onatsimsek/EE464-Hardware-Project-The-Isolated-Ones/README.md

# EE464-Hardware-Project-The-Isolated-Ones
