onatsimsek/EE464-Hardware-Project-The-Isolated-Ones/EE 464 Term Project (1).pptx

## EE 464 Term Project

The Isolated Ones

Selen Özge Özgür 2375566
Onat Şimşek 2375772
Onur Emirhan Con 2304384

## Outline

Topology Selection
Magnetic Design
Simulation Results
Component Selection

## Topology Selection

| Efficiency | Output Ripple | Power Range | Complexity | Cost
Flyback Converter | Moderate efficiency | Higher output ripple | Low to medium power | Least Complex | Cheapest
Forward Converter | Better efficiency | Lowest output ripple | Medium to high power | Medium Complexity | Medium
Push-Pull Converter | Can also have good efficiency | Moderate output ripple | Medium power | Most Complex | Most Expensive

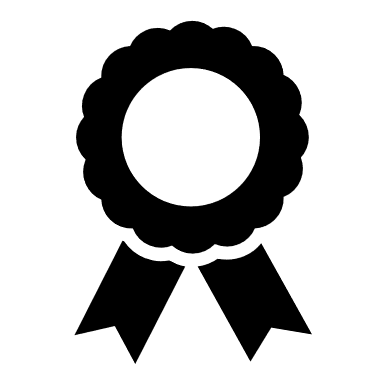
[picture p15: figure]
Ribbon with solid fill

## Topology Selection

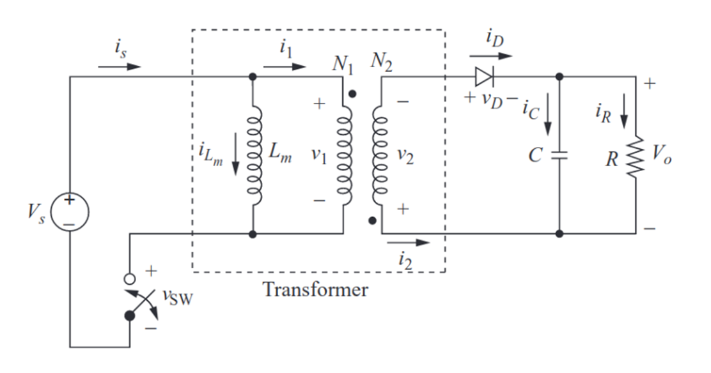
[picture p16: figure]

Flyback Converter

## Magnetic Design

- Duty cycle range is determined
- Turns ratio is determined to be 1:1, according to duty cycle
- Lm is calculated according to specifications (Vin, Dmax, Bmax, etc.)
- Core is determined after some research (ETD 39/20/13)
  - B66363G1000X187 with a gap of 1 mm
  - N87 type SIFERRIT material
- Minimum number of turns required for the primary winding is determined
- Exact number of turns is determined as 11
- Lm is calculated again
- B is calculated again to double check the design

## Magnetic Design

Duty Cycle Range | Turns Ratio | Bmax | Calculated Lm | AL of the Core
0.24-0.39 | 1:1 | 0.2 T | 23.18 μH | 196 nH/T^2

## Magnetic Design

Min # of Turns | # of Turns | Final Lm | Final Bmax | Switching Freq.
≈ 8 | ≈ 11 | 23.72 μH | 0.215 T | 80kHz

## Magnetic Design

Skin Depth | Cable Type | # of Parallel Cables | Window Area of the Core | Fill Factor
0.265 mm | AWG 26 | 27 | 178 mm^2 | 0.46

## Magnetic Design

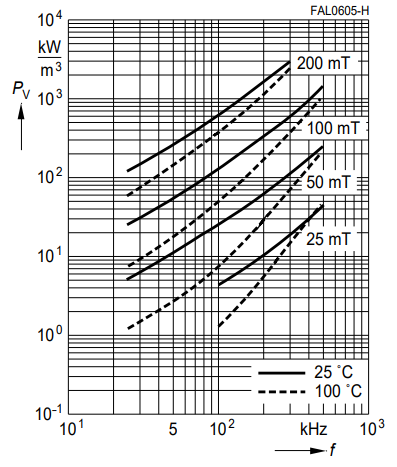
[picture p17: figure]

Copper Losses | Core Losses
0.67 W | 3.45 W

## Magnetic Design Results

Primary Winding Inductance

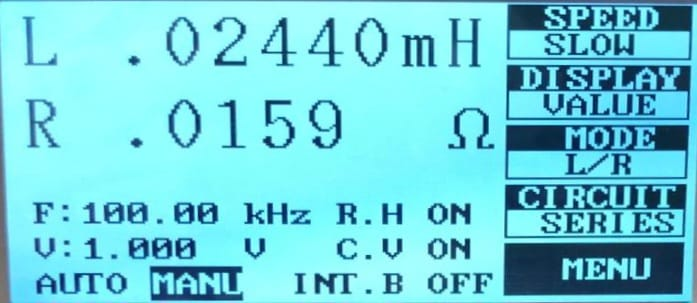
[picture p18: figure]

Leakage Inductance

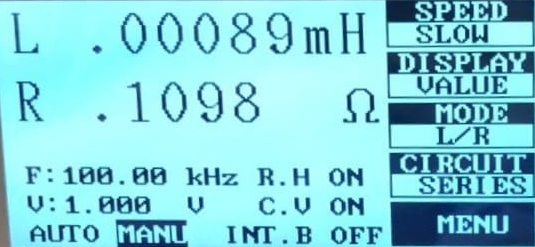
[picture p19: figure]

## Simulation Results

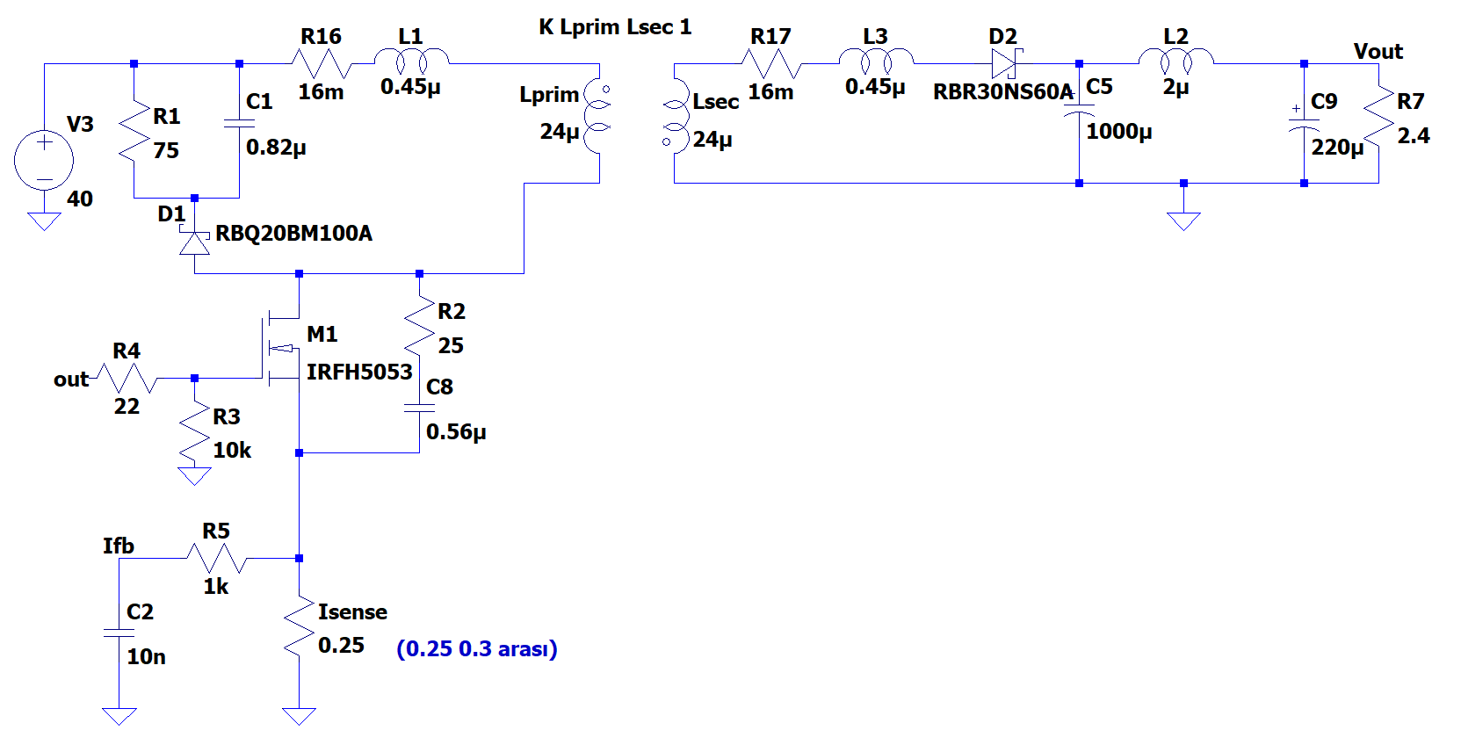
[picture p20: figure]

Flyback Converter Design

## Simulation Results

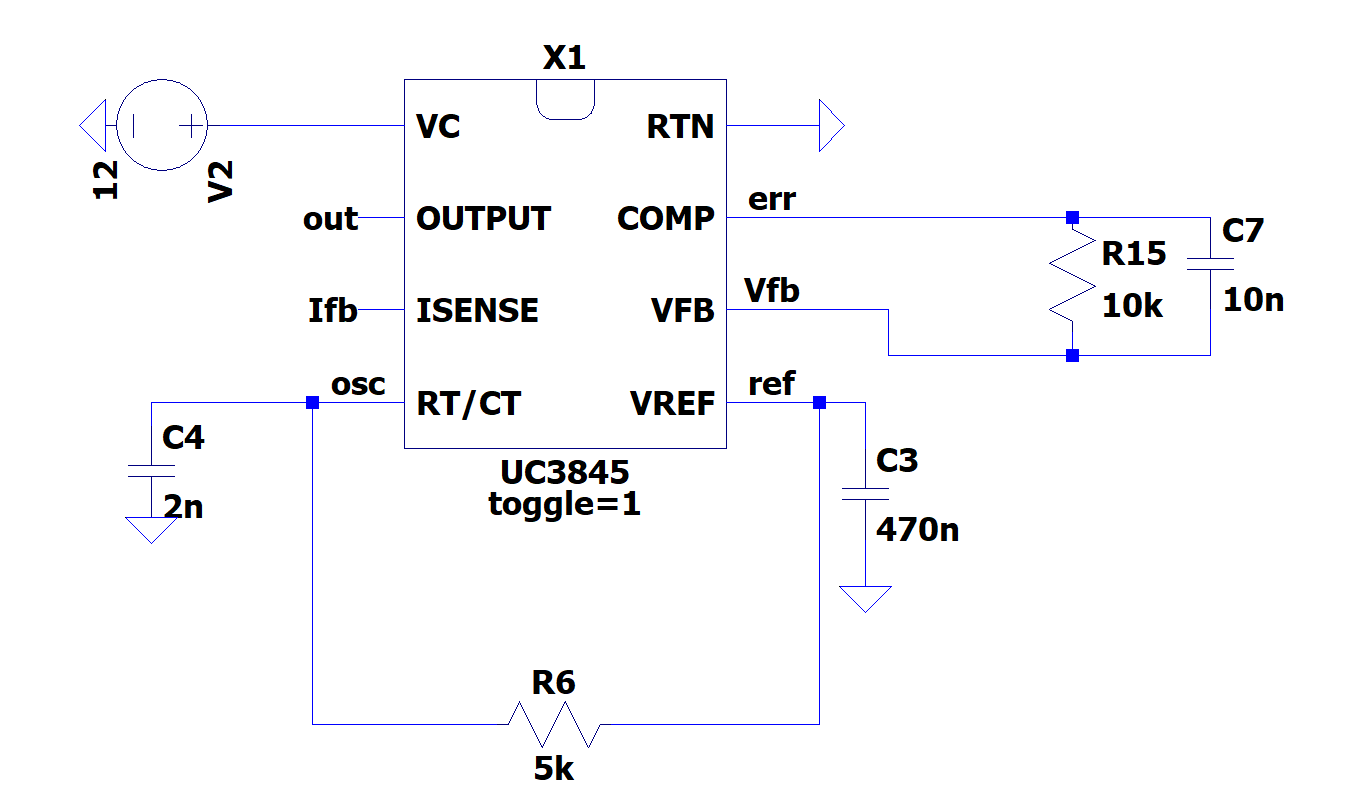
[picture p21: figure]

Controller Design

## Simulation Results

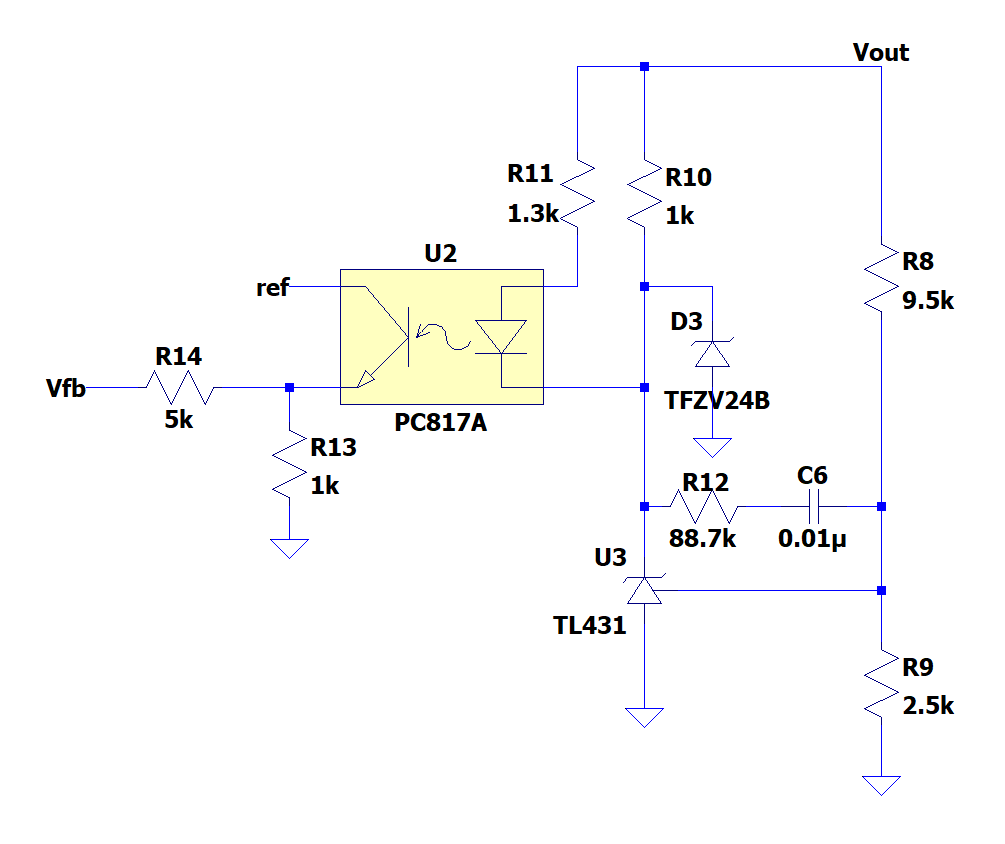
[picture p22: figure]

Optocoupler Design

## Simulation Results

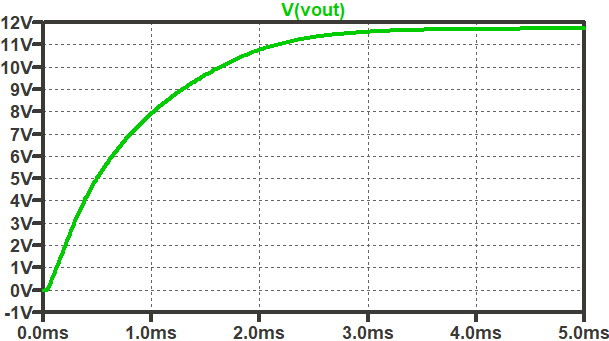
[picture p23: figure]

Output Voltage Waveform for 20 V Input Voltage
(Steady state voltage : 11.7 V)

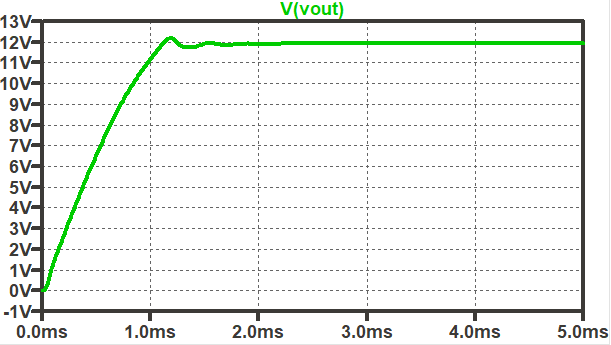
[picture p24: figure]

Output Voltage Waveform for 40 V Input Voltage
(Steady state voltage : 12 V)

## Simulation Results

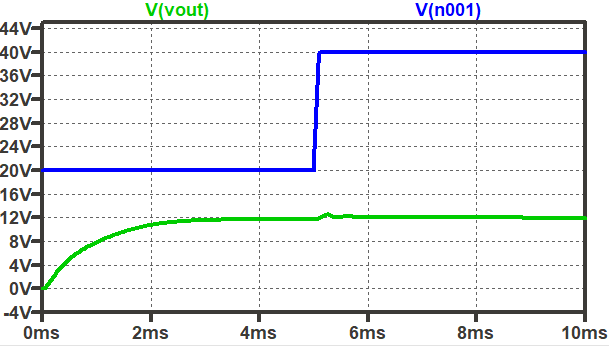
[picture p25: figure]

Line Regulation: %5 (12.5V)

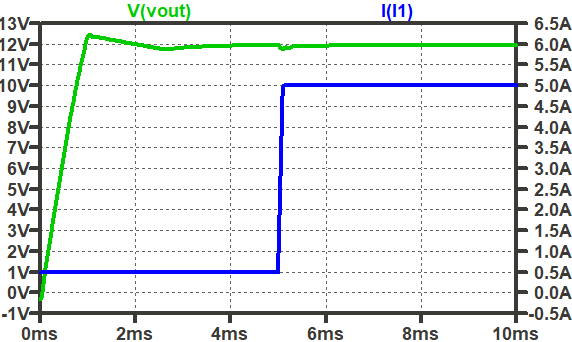
[picture p26: figure]

Load Regulation: %2 (11.76V)

## Simulation Results

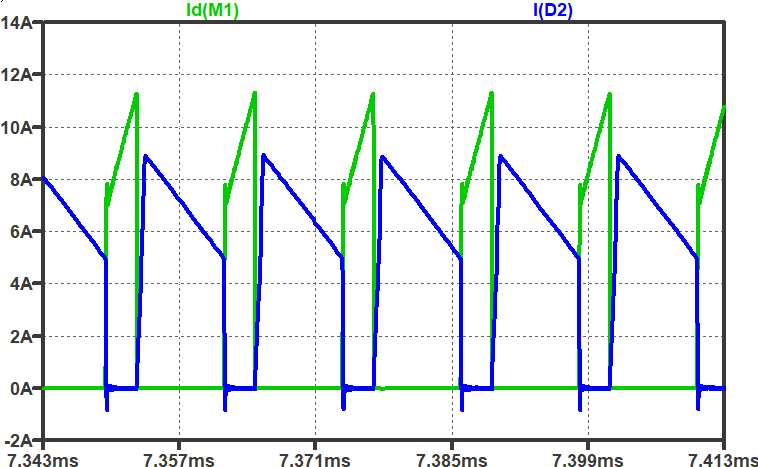
[picture p27: figure]

MOSFET (Green) & Diode (Blue) Currents

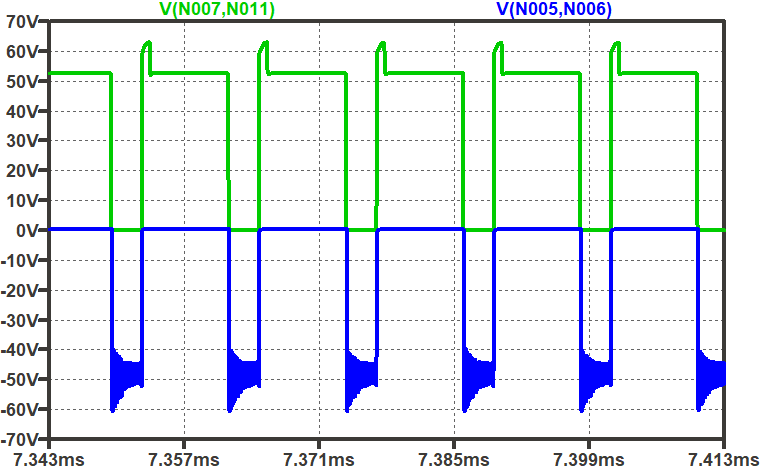
[picture p28: figure]

MOSFET (Green) & Diode (Blue) Voltages

## Component Selection

- MOSFET Selection
- Secondary Diode Selection
- RCD Snubber Diode Selection
- Rsense Selection

## MOSFET

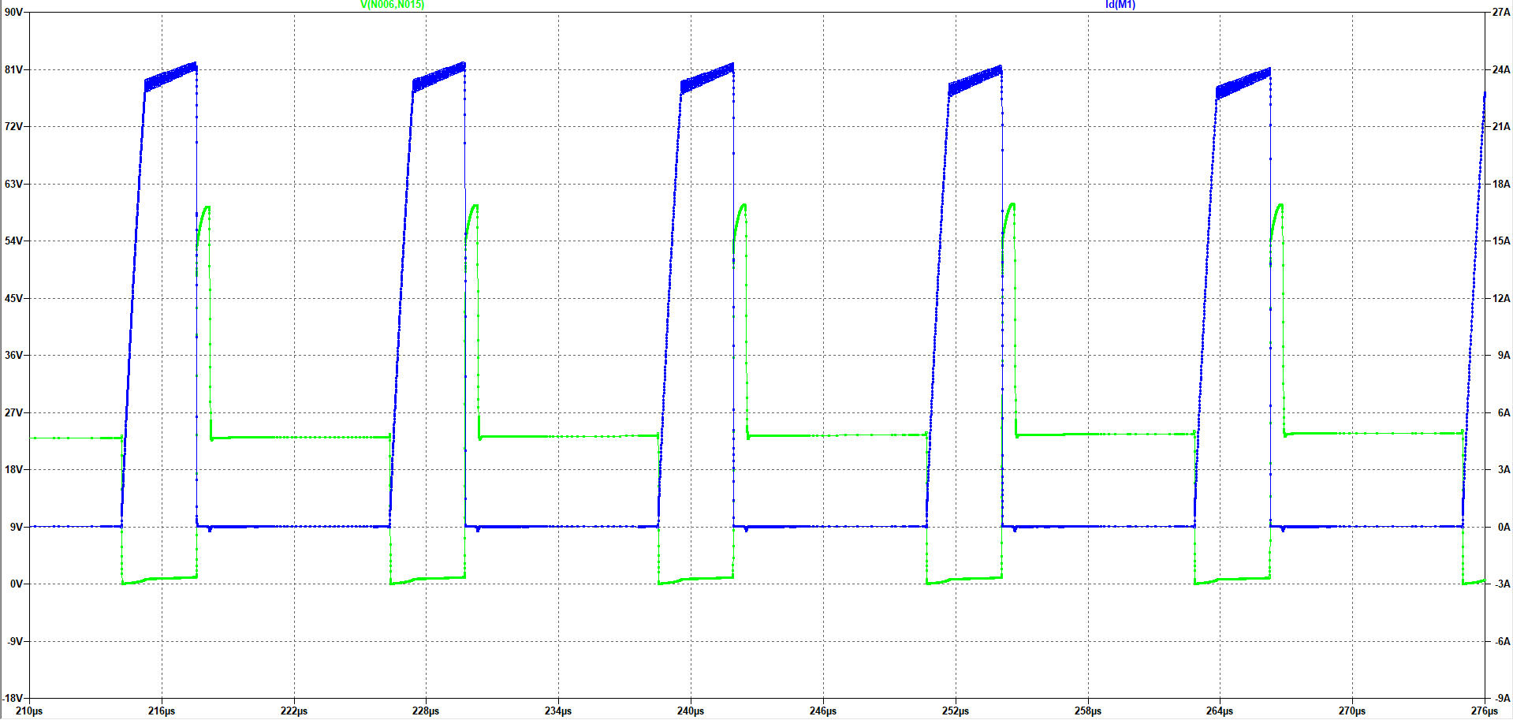
[picture p29: figure]

Voltage and Current Waveforms of the MOSFET for 20V Input Voltage

Max Voltage: 85V
Max Current: 25A

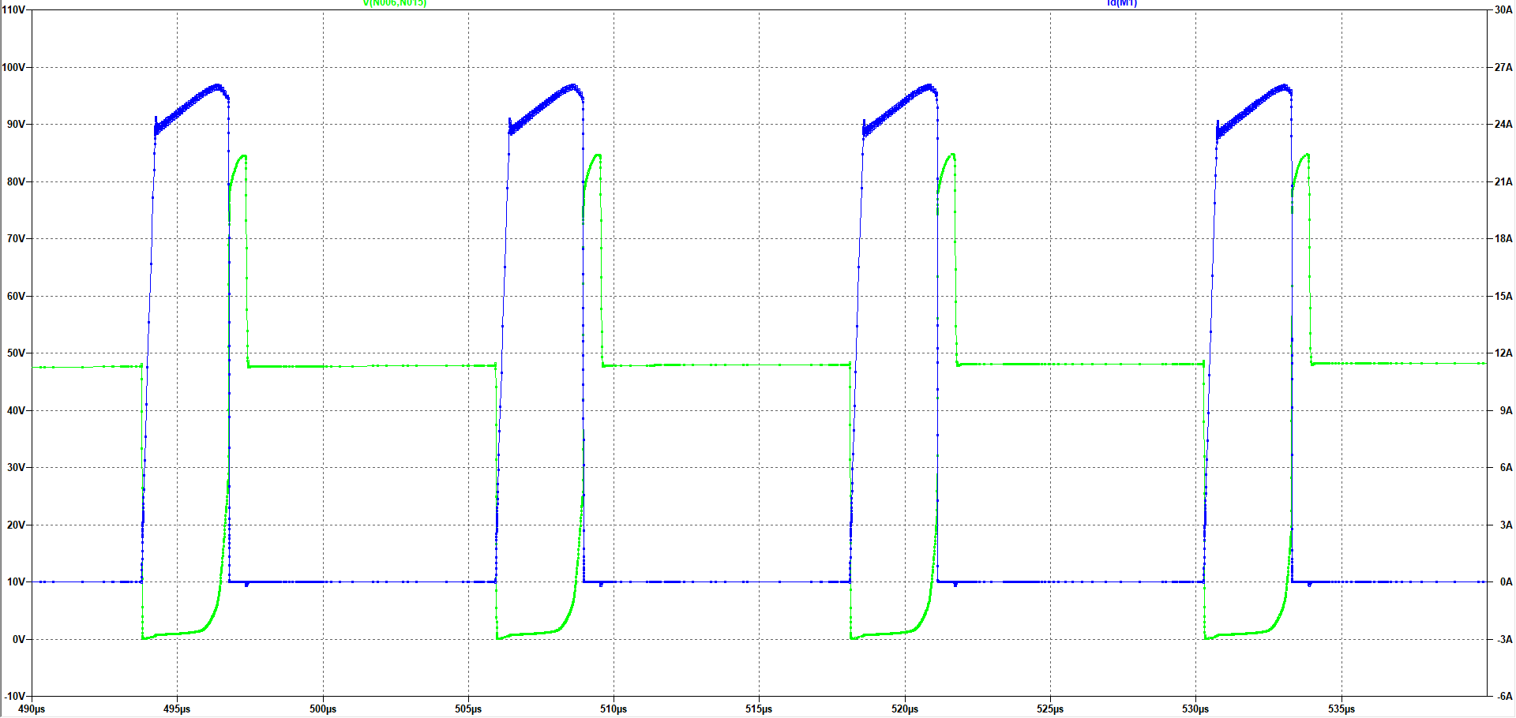
[picture p30: figure]

Voltage and Current Waveforms of the MOSFET for 40V Input Voltage

IRFZ540N (33A 100V)

## Secondary Diode

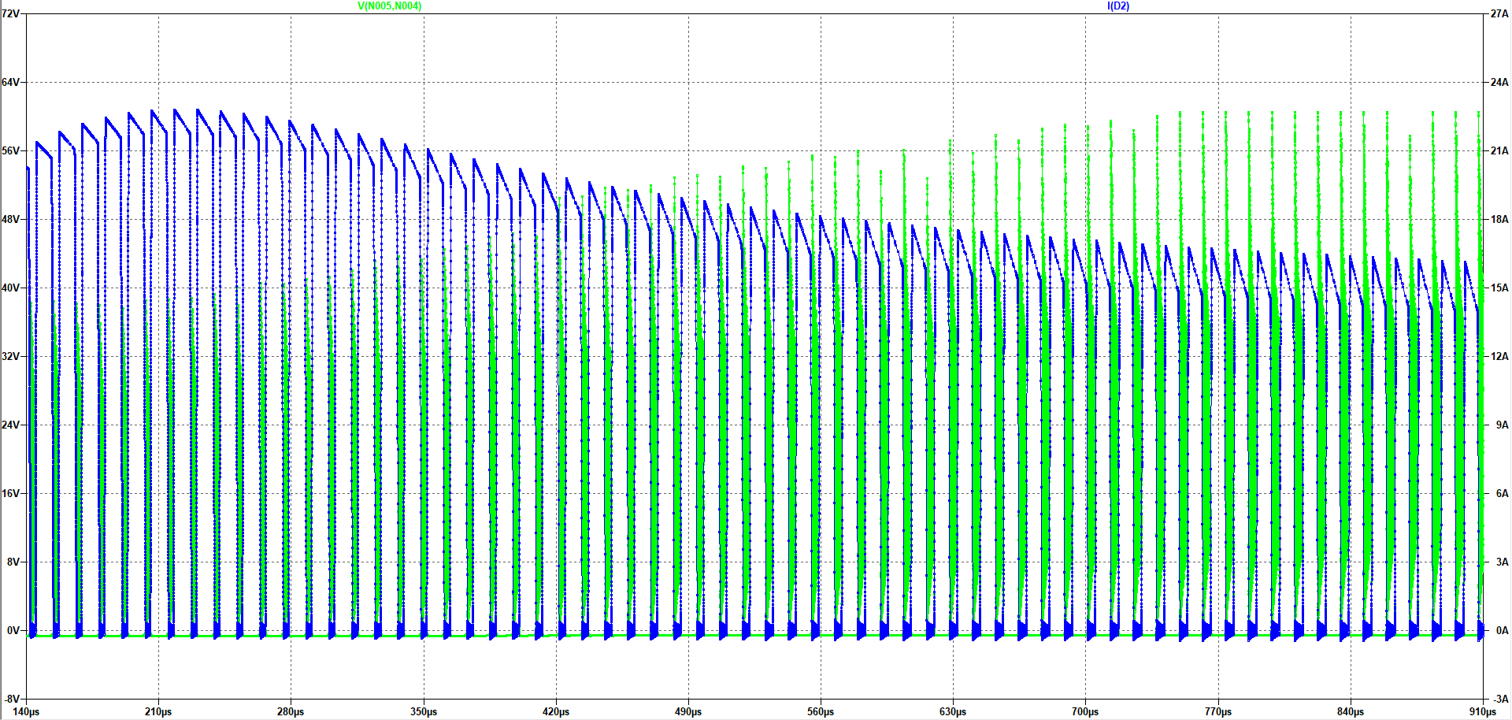
[picture p31: figure]

Voltage and Current Waveforms of the Secondary Diode for 20V Input Voltage

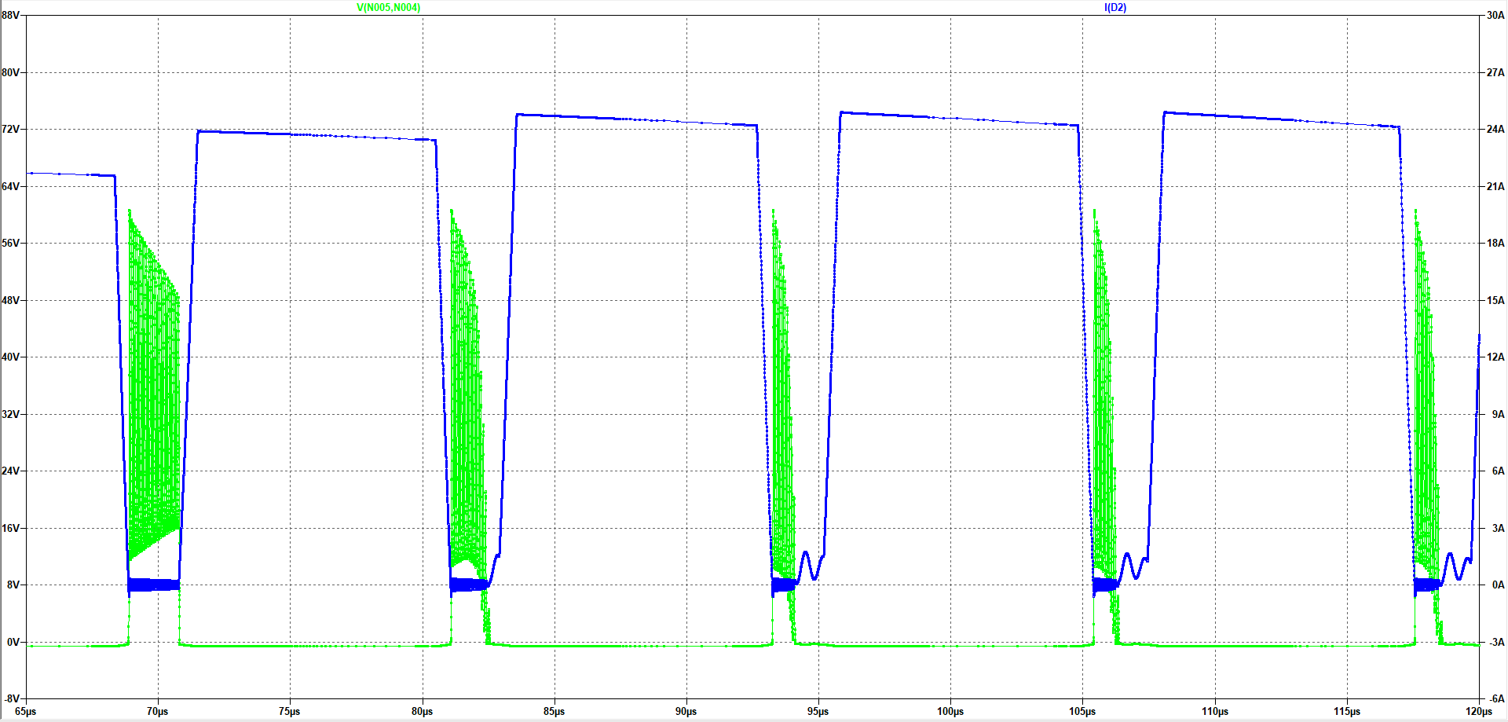
[picture p32: figure]

Voltage and Current Waveforms of the Secondary Diode for 40VInput Voltage

Max Voltage: 60V
Max Current: 25A

DSA30I100PA(30A 100V)

## RCD Snubber Diode

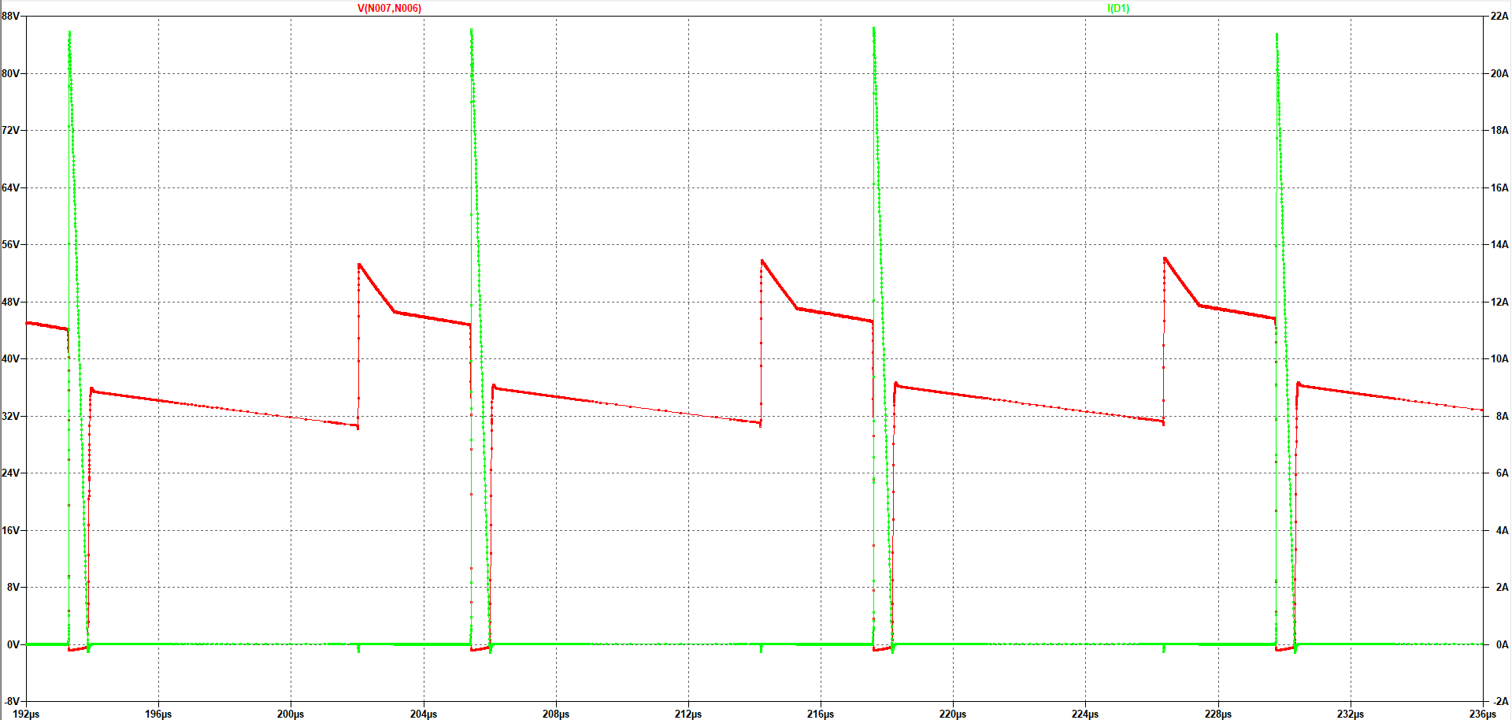
[picture p33: figure]

Voltage and Current Waveforms of the RCD Diode for 20V Input Voltage

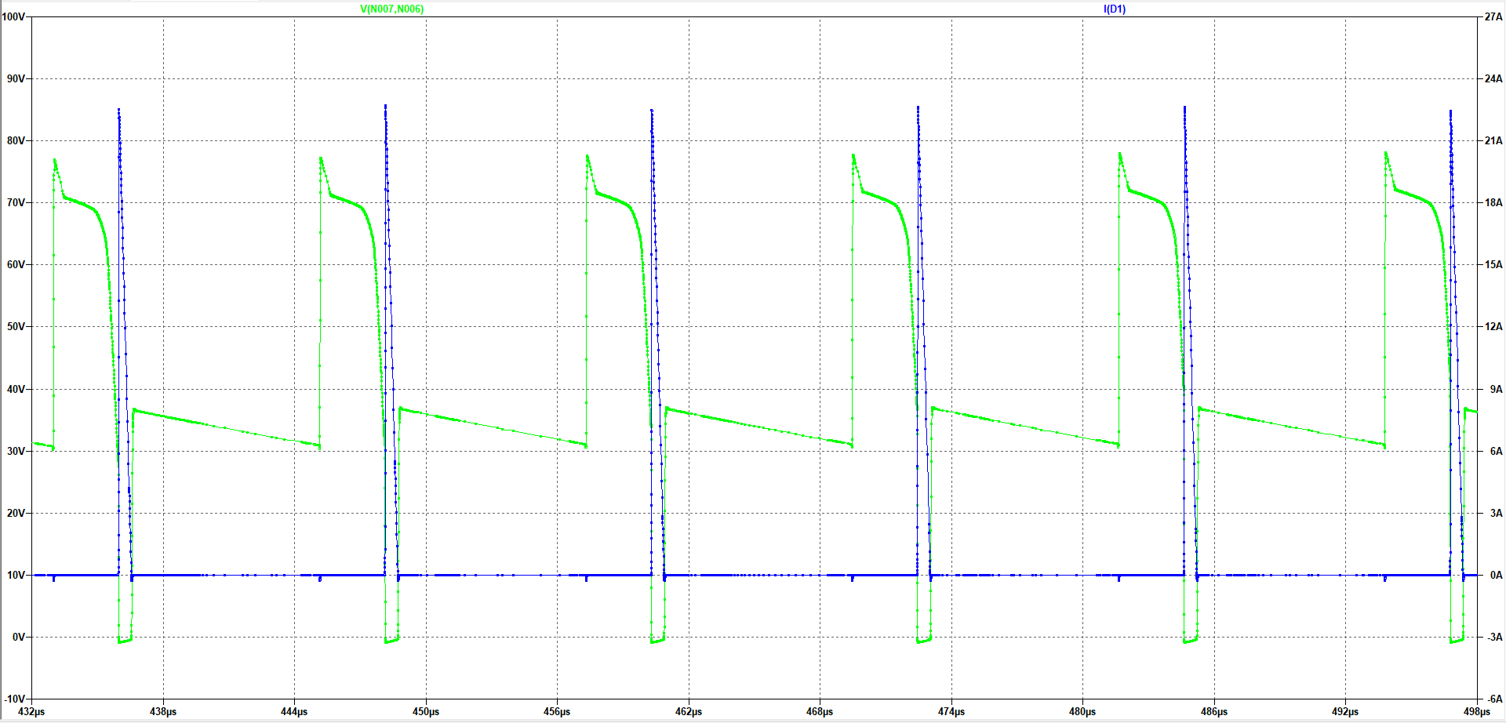
[picture p34: figure]

Voltage and Current Waveforms of the RCD Diode for 40V Input Voltage

Max Voltage: 78V
Max Current: 23A

DSA30I100PA(30A 100V)

## Rsense

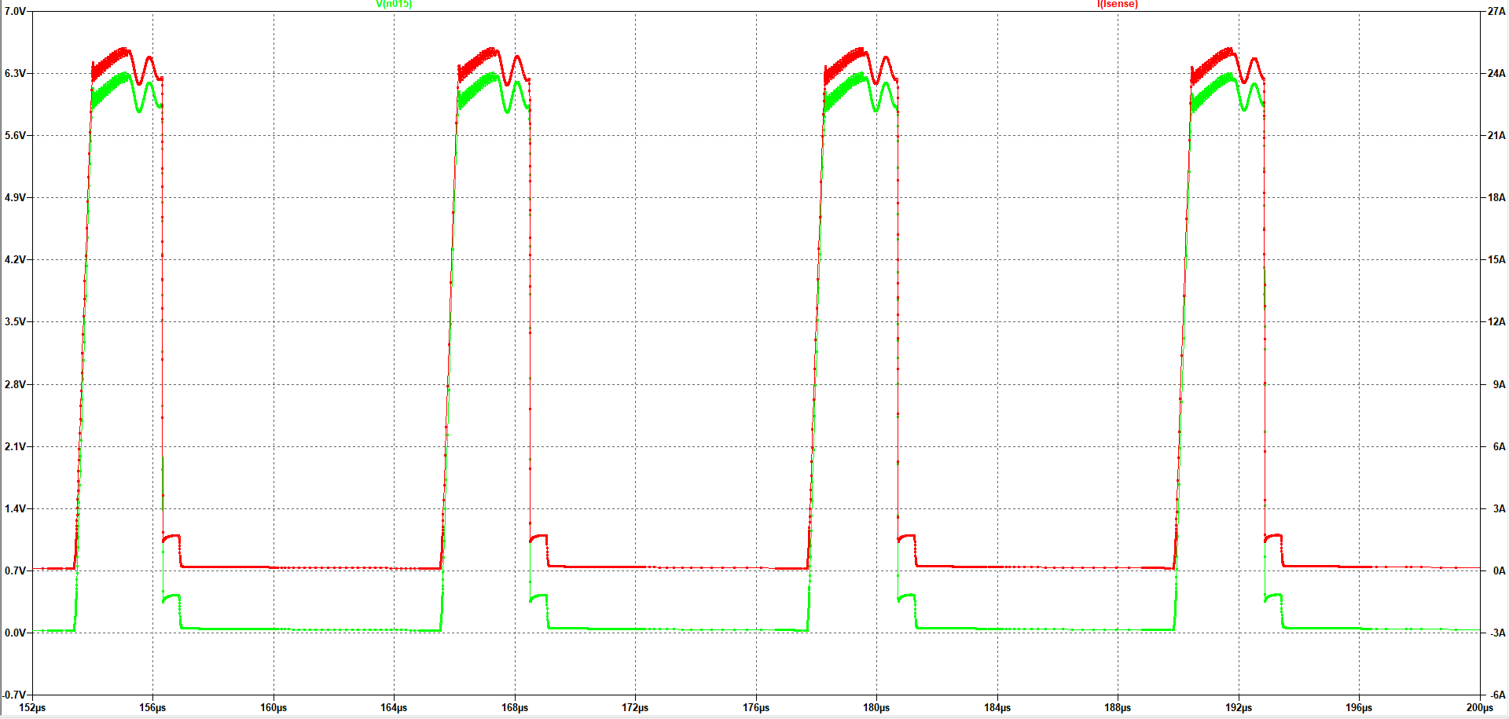
[picture p35: figure]

Voltage and Current Waveforms of the RSense for 20V Input Voltage

Max Voltage: 6.3V
Max Current: 25.2A
R = 0.25 ohm

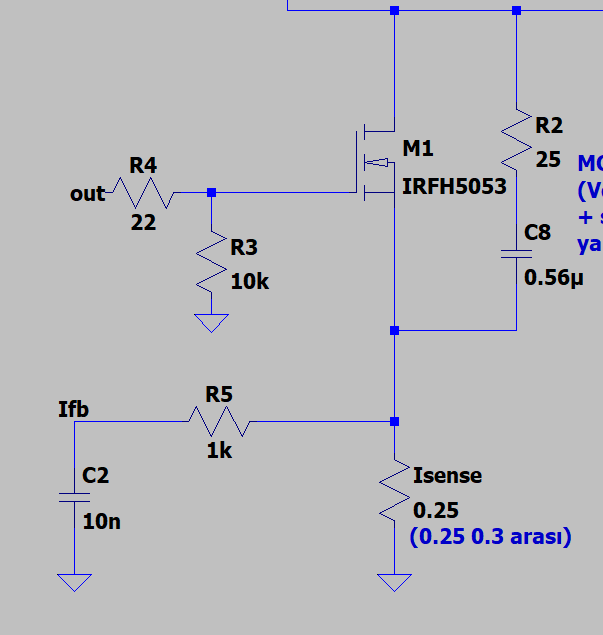
[picture p36: figure]

ACS712 Current Sensor
+
Opamp Amplifier

## Thank You for Your Listening
