onatsimsek/EE464-Hardware-Project-The-Isolated-Ones/RCD_Clamp_Design_Tool_v1.0.xlsx

Sheet: RC Clamp Design
Biricha Flyback Converter RCD Clamp Design Tool*
* See C. Basso “Switch-Mode Power Supplies Spice Simulations and Practical Designs” for full proofs of equations
Input values in dark yellow cells
Results are shown in light red
Type in the Necessary Parameters
Step 1: Input the maximum voltage allowed on the switch, Vmax |  |  | 80.00 | V
Step 2: Input the PSU input voltage, Vin |  |  | 40.00 | V
Step 3: Input Flyback transformer primary to secondary turn ratio, N |  |  | 1.00 | n:1
Step 4: Input PSU switching frequency, Fs |  |  | 100000 | Hz
Step 5: Input PSU output voltage Vout |  |  | 12.00 | V
Step 6: Input total leakage as seen on primary |  |  | 2.5e-07 | H
Step 7: Input peak primary current Ipeak (from Biricha WDS design tool ) |  |  | 15.00 | A
Calculated Component Values
Rclamp (ohms) | Cclamp (F) | Power Loss in Clamp (W)
398.2222222 | 6.277901786e-08 | 4.017857143

Sheet: Transformer Parameter Referral
Biricha Transformer Parameter Referral Tool
 |  |  |  |  | V_pri | Real primary voltage
 |  |  |  |  | V_sec | Real secondary voltage
 |  |  |  |  | V_pri_referred | Primary voltage referred to secondary
 |  |  |  |  | V_sec_referred | Secondary voltage referred to primary
 |  |  |  |  | I_pri | Real primary current
 |  |  |  |  | I_sec | Real secondary current
 |  |  |  |  | I_pri_referred | Primary current referred to secondary
 |  |  |  |  | I_sec_referred | Secondary current referred to primary
 |  |  |  |  | L_L1 | Real primary leakage inductance
 |  |  |  |  | L_L2 | Real secondary leakage inductance
 |  |  |  |  | L_L1_referred | Primary primary leakage inductance referred to secondary
 |  |  |  |  | L_L2_referred | Secondary primary leakage inductance referred to primary
 |  |  |  |  | R_pri | Real primary resistance
 |  |  |  |  | R_sec | Real secondary resistance
 |  |  |  |  | R_pri_referred | Primary resistance referred to secondary
 |  |  |  |  | R_sec_referred | Secondary resistance referred to primary
 |  |  |  |  | N | primary to secondary turn ratio (n:1)
 |  |  |  |  | Lm | Magnetizing Inductance
Referring Parameters from Primary to Secondary
Input N | Input V_sec (V) | V_sec_referred (V) | Input L_L2 (H) | L_L2_referred (H) | Input L_L1 (H) | Total Leakage Inductance as seen on primary (H)
10.00 | 3.00 | 30.00 | 1e-07 | 1e-05 | 1e-05 | 2e-05
 | Input Isec (A) | I_sec_referred (A) | Input R_sec (A) | R_sec_referred (A)
 | 3.00 | 0.30 | 10 | 1000
Referring Parameters from Secondary to Primary
Input N | Input V_pri (V) | V_pri_referred (V) | Input L_L1 (H) | L_L2_referred (H) | Input L_L1 (H) | Total Leakage Inductance as seen on primary (H)
3.00 | 9.00 | 3.00 | 1e-07 | 1.111111111e-08 | 1e-05 | 1.001111111e-05
 | Input Isec (A) | I_sec_referred (A) | Input R_sec (ohms) | R_sec_referred (ohms)
 | 1.00 | 3.00 | 3 | 0.3333333333
