onatsimsek/EE464-Hardware-Project-The-Isolated-Ones/flyback_powerdesign.asc

C1: cap; 4.7µ
C4: cap; 4.7µ
C5: cap; 330µ
C6: cap; 270µ
C7: cap; 120p
C8: cap; 22p
C9: cap; 100n
C10: cap; 1n
C11: cap; 1n
C12: cap; 470p
D1: diode
D3: diode
L4: ind; 1.5µ
L5: ind; 19µ
Lprim: ind2; 100µ
Lsec: ind2; 100µ
M1: nmos; IRFR120Z
R3: res; 192
R4: res; 192
R6: res; 10
R7: res; 13.7k
R8: res; 3.6k
R9: res; 4.87k
R10: res; 2.21k
R11: res; 365k
R12: res; 2.55k
R13: res; 4.99k
R14: res; 39m
R15: res; 7.87
R16: res; 1k
R17: res; 10.7k
R18: res; 10k
U1: tl431
U2: PC817A
V1: voltage; 20
V2: voltage; 10
X1: UC3845; toggle=1
Named nets: Ifb, rt/ct, Vfb, ref, comp, out, 0, Vout, SecGND, Vc, Drain
.tran 0 5m 1u uic
.options Trtol=9 Method=trapmod
UC3845 test schematic, copied
from analogspiceman's example,
but using a different model.
 
Vlad, groups.io
.include tl431.mod
K Lprim Lsec 1
