onatsimsek/EE464-Hardware-Project-The-Isolated-Ones/UC3845 simulation.asc

C2: cap; 100n
C4: polcap; 20µ; V=63 Irms=2.92 Rser=0.004 Lser=5.32n
C5: polcap; 10n; V=50 Irms=1.87845 Rser=0.07 Lser=0
C6: cap; 39µ; V=35 Irms=2.7 Rser=0.0113 Lser=5.18n mfg="Würth Elektronik" pn="875075655001 WCAP-PSLC 8 x 11,7" type="Al polymer"
C7: polcap; 470µ; V=450 Irms=1.94 Rser=0.086 Lser=8n mfg="Würth Elektronik" pn="861141485033 WCAP-AI3H 30x40" type="Al electrolytic"
C8: cap; 0.01µ
D1: schottky; MBR20100CT
D2: diode
D3: diode; MMSD4148
D4: diode
L1: ind2; 100µ
L2: ind2; 100µ
L3: ind2; 10µ
L4: ind; 1.5µ
Lm1: ind; 19µ
M1: nmos
R1: res; 22
R2: res; 100k
R3: res; 88.7k
R4: res; 1k
R5: res; 0.75
R6: res; 1
R8: res; 5
R9: res; 4.606m
R10: res; 4.606m
R11: res; 50k
R12: res; 1.3k
R13: res; 9.53k
R14: res; 2.49k
U2: PC817C
U3: RH1009
V1: voltage; 30
X1: UC3845; toggle=1
Named nets: 0, Vin, Vout
.tran 10m startup
K L1 L2 L3 1
