onatsimsek/EE464-Hardware-Project-The-Isolated-Ones/Closed loop- nonisolatedflyback.asc

C1: cap; 39µ; V=35 Irms=2.7 Rser=0.0113 Lser=5.18n mfg="Würth Elektronik" pn="875075655001 WCAP-PSLC 8 x 11,7" type="Al polymer"
C2: cap; 6800p
C3: polcap; 4.7µ
C4: cap; .01µ
C5: polcap; 20µ; V=63 Irms=2.92 Rser=0.004 Lser=5.32n
C6: polcap; 18µ; V=50 Irms=1.87845 Rser=0.07 Lser=0 mfg="KEMET" pn="T521X186M050ATE070" type="Tantalum"
C7: polcap; 470µ; V=450 Irms=1.94 Rser=0.086 Lser=8n mfg="Würth Elektronik" pn="861141485033 WCAP-AI3H 30x40" type="Al electrolytic"
D1: diode
D2: schottky; MBR20100CT
L1: ind; 10µ
L2: ind2; 100µ
L3: ind2; 100µ
Lm1: ind; 19µ
Q1: NMOS; FDS6680A
R1: RES; 41.2K
R2: res; 20k
R3: res; 130k
R4: res; 22K
R5: res; 43.2K
R6: res; 200K
R7: res; .01
R8: res; 5
R9: res; 4.606m
R10: res; 4.606m
R11: res; 500k
U1: LT3757A
V2: voltage; 20
Named nets: 0, Vin, Vout
.tran 1.5m startup
K L2 L3 1
