onatsimsek/EE464-Hardware-Project-The-Isolated-Ones/Flyback_deneme 2.asc

C1: cap; 20µ
C2: cap; 20µ
C3: cap; 20µ
C4: cap; 100n
C5: cap; 58p
C6: cap; 470n
C7: cap; 69n
C8: cap; 1µ
D1: schottky; 1N5818
L1: ind2; 100µ
L2: ind2; 100µ
Lm: ind; 19µ
M1: nmos; BSP89
R1: res; 4.606m
R2: res; 5
R3: res; 4.606m
R4: res; 21.5m
R5: res; 89.1k
R6: res; 10k
R7: res; 100k
R8: res; 549k
R9: res; 549k
R10: res; 549k
R11: res; 19.8k
R12: res; 4.99k
R13: res; 4.99k
R14: res; 2.49k
R15: res; 221
R16: res; 470
U1: MAX17597
U2: PC817C
U4: RH1009
V1: voltage; 20
Named nets: 0, Vin, Vout, Vdrv, Vfb
.param D=0.35
.param fs=100k
K L1 L2 1
.tran 10m
