onatsimsek/EE464-Hardware-Project-The-Isolated-Ones/(commit log)

2024-04-11 MAX17596
    We might use this as controller. It includes over current and over voltage protection. Problem is, I couldn't find LTSpice model. I did the simulation with MAX17597 but 17597 is not for flyback control.
2024-04-11 closed loop- nonisolated flyback converter
    LT3757 controller is used. Voltage changes is unaccaptable at this point but will be updated in the following days
2024-04-13 rcd clamp design tool
    [RCD_Clamp_Design_Tool_v1.0.xlsx]
2024-04-16 transformer input current & number of paralllel cables revised
2024-04-17 TI Power Design Simulation
    Download TL431 and UC3845 Model in order to run the simulation
2024-04-17 Secondary Ground is fixed
2024-04-19 simulation with UC3845, RCD clamper, and optocupler
2024-04-20 Simulation Results and Magnetic Design Part Done
    Component Selection part left
2024-04-20 Changes
    set the frequency to 75kHz, added transformer resistance to both primary and secondary
2024-04-20 Minor Changes
    set the frequency to 75kHz, added transformer resistance at both primary and secondary
